bauzel/rp2040-mcu-design/rp2040mcu/rp2040.kicad_pcb

## KiCad design rp2040mcu/rp2040.kicad_pcb (2026-10-27)

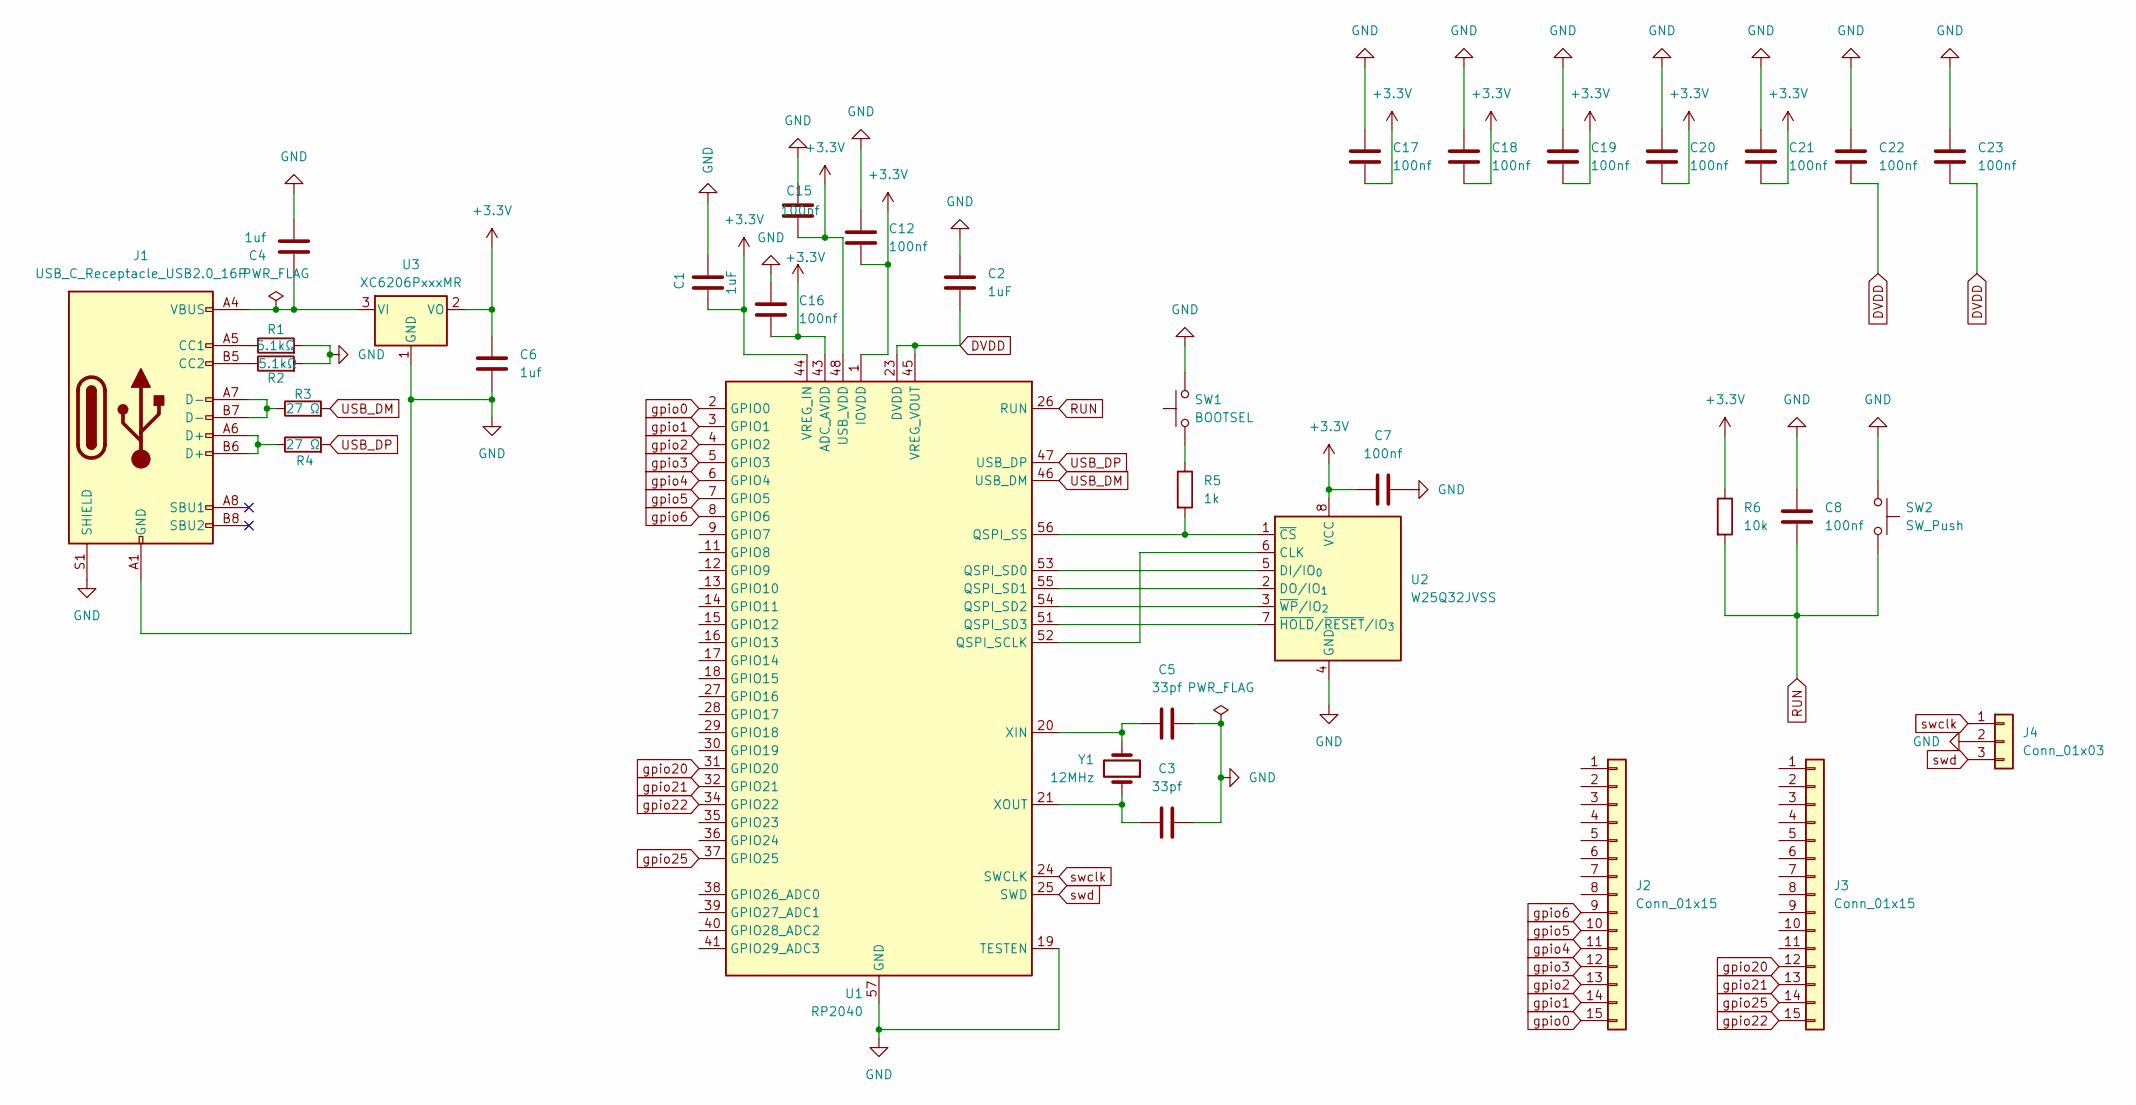
[picture p1: schematic rp2040.kicad_sch]

Parts:
C1, C2: 1uF; C_0603_1608Metric
C3, C5: 33pf; C_0603_1608Metric
C4, C6: 1uf; C_0603_1608Metric
C7, C8, C12, C15, C16, C17, C18, C19, C20, C21, C22, C23: 100nf; C_0603_1608Metric
J1: USB_C_Receptacle_USB2.0_16P; USB_C_Receptacle_GCT_USB4105-xx-A_16P_TopMnt_Horizontal
J2, J3: Conn_01x15; PinHeader_1x15_P2.54mm_Vertical
J4: Conn_01x03; PinHeader_1x03_P2.54mm_Vertical
R1, R2: 5.1kΩ; R_0603_1608Metric
R3, R4: 27 Ω; R_0603_1608Metric
R5: 1k; R_0603_1608Metric
R6: 10k; R_0603_1608Metric
SW1: BOOTSEL; SW_SPST_B3U-1000P
SW2: SW_Push; SW_SPST_B3U-1000P
U1: RP2040; QFN-56-1EP_7x7mm_P0.4mm_EP3.2x3.2mm
U2: W25Q32JVSS; SOIC-8_5.3x5.3mm_P1.27mm
U3: XC6206PxxxMR; SOT-23-3
Y1: 12MHz; Crystal_SMD_5032-2Pin_5.0x3.2mm

Connections:
+3.3V: C1.1, C6.1, C7.1, C12.2, C15.2, C16.2, C17.2, C18.2, C19.2, C20.2, C21.2, R6.1, U1.1 (IOVDD), U1.10 (IOVDD), U1.22 (IOVDD), U1.33 (IOVDD), U1.42 (IOVDD), U1.43 (ADC_AVDD), U1.44 (VREG_IN), U1.48 (USB_VDD), U1.49 (IOVDD), U2.8 (VCC), U3.2 (VO)
DVDD: C2.2, C22.2, C23.2, U1.23 (DVDD), U1.45 (VREG_VOUT), U1.50 (DVDD)
GND: C1.2, C2.1, C3.2, C4.2, C5.2, C6.2, C7.2, C8.1, C12.1, C15.1, C16.1, C17.1, C18.1, C19.1, C20.1, C21.1, C22.1, C23.1, J1.A1 (GND), J1.A12 (GND), J1.B1 (GND), J1.B12 (GND), J1.S1 (SHIELD), J4.2, R1.2, R2.2, SW1.2, SW2.1, U1.19 (TESTEN), U1.57 (GND), U2.4 (GND), U3.1 (GND)
unnamed: J1.A5 (CC1), R1.1
unnamed: J1.B5 (CC2), R2.1
unnamed: J1.A6 (D+), J1.B6 (D+), R4.1
unnamed: J1.A7 (D-), J1.B7 (D-), R3.1
unnamed: R5.1, SW1.1
unnamed: U1.52 (QSPI_SCLK), U2.6 (CLK)
unnamed: U1.53 (QSPI_SD0), U2.5 (DI/IO_{0})
unnamed: U1.55 (QSPI_SD1), U2.2 (DO/IO_{1})
unnamed: U1.54 (QSPI_SD2), U2.3 (~WP/IO_{2})
unnamed: U1.51 (QSPI_SD3), U2.7 (~HOLD/~RESET/IO_{3})
unnamed: R5.2, U1.56 (QSPI_SS), U2.1 (~CS)
unnamed: C5.1, U1.20 (XIN), Y1.2
unnamed: C3.1, U1.21 (XOUT), Y1.1
unnamed: C4.1, J1.A4 (VBUS), J1.A9 (VBUS), J1.B4 (VBUS), J1.B9 (VBUS), U3.3 (VI)
RUN: C8.2, R6.2, SW2.2, U1.26 (RUN)
USB_DM: R3.2, U1.46 (USB_DM)
USB_DP: R4.2, U1.47 (USB_DP)
gpio0: J2.15, U1.2 (GPIO0)
gpio1: J2.14, U1.3 (GPIO1)
gpio2: J2.13, U1.4 (GPIO2)
gpio3: J2.12, U1.5 (GPIO3)
gpio4: J2.11, U1.6 (GPIO4)
gpio5: J2.10, U1.7 (GPIO5)
gpio6: J2.9, U1.8 (GPIO6)
gpio20: J3.12, U1.31 (GPIO20)
gpio21: J3.13, U1.32 (GPIO21)
gpio22: J3.15, U1.34 (GPIO22)
gpio25: J3.14, U1.37 (GPIO25)
swclk: J4.1, U1.24 (SWCLK)
swd: J4.3, U1.25 (SWD)

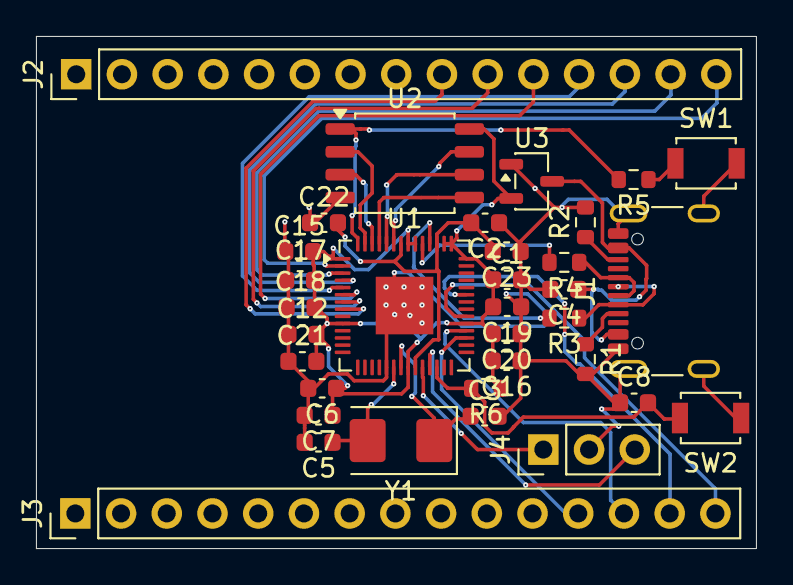
[picture p2: board rp2040.kicad_pcb from above]

Board: 4 copper layers, 40.0 x 28.4 mm, 34 parts (0 on the bottom side), 33 nets.
